capitaoananas/BRUV-mini/README.md

# Firefly Tinywhoop

A 75mm tinywhoop drone with a custom frame and canopy, made for indoors and outdoors

---

## Features

- **Small** – fly indoors and outdoors with the 75mm wheelbase
- **0802 motors** – Great speed and size!
- **AIO board** – (All In One) FC+ESC+OSD+VTX+RX
- **31mm props** – good efficiency and performance, aso can use 35mm props, no prop guards but who needs them?

---

## Bill of Materials (BOM)

| Part | Quantity | Price  | Link | Notes |
| --- | --- | --- | --- | --- |
| Matrix 1S FC (5in1) | 1 | $57.45 | [tinywhoop](https://www.tinywhoop.com/collections/electronics/products/matrixfc) |
| CADDXFPV Ant Lite Camera | 1 | $15.90 | [caddxfpv](https://caddxfpv.com/products/caddxfpv-ant-lite-4-3-fpvcycle-edition) |
| 802 25KKV Motors | 1 | $46.850 | [tinywhoop](https://www.tinywhoop.com/collections/802-motors/products/802-25kkv-calliope-edition-project-topspin-tiny-whoop-motors) |
| Gemfan 31mm props | 4 | $4.01 | [aliexpress](https://pt.aliexpress.com/item/1005009122072902.html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) |
| BT2.0 300mAh 1S battery | 1 pack of 4  | $19.99 | [betafpv](https://betafpv.com/collections/batt-1s/products/bt2-0-450mah-1s-30c-battery-4pcs) |
| m2x10 screws | 4 | $3.48 |  [aliexpress](https://pt.aliexpress.com/item/1005007249068859.html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) |
| nylon m2 nuts | 8 | $1.31 | [aliexpress](https://pt.aliexpress.com/item/1005005203028580.html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) |
| Carbon Fiber Sheet | 1 | $21.80 | [aliexpress](https://pt.aliexpress.com/item/1005008721256378.html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) |
| Radiomaster pocket controller | 1 | $76.36 | [aliexpress](https://pt.aliexpress.com/item/1005009135876837.html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) |

Total: `$247.15` + shipping
so needed ~$270+

---

## Drone overview

I made the frame and canopy in Fusion

### Frame

Side             |  Top
:-------------------------:|:-------------------------:
frame side  |  Frame top

---

### Canopy

Side             |  Top
:-------------------------:|:-------------------------:
canopy side  |  canopy top

Side (3D printed)             |  Side with frame (3D printed)
:-------------------------:|:-------------------------:
canopy side  |  canopy with frame side

---

### Final renders

i was not able to bend the canopy in Fusion so its not in the final renders

Side              |  Top             | Bottom
:-------------------------:|:-------------------------:|:-------------------------:
Render side  |  Render top | Render bottom

---
