capitaoananas/BRUV-mini/3D/antena mount.stl

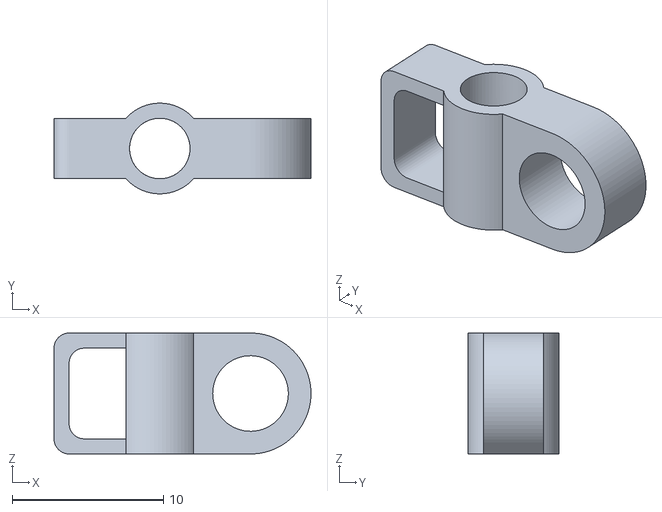
[picture p1: CAD file, 2025-06-12]
3D/antena mount.stl
17.0 x 5.99 x 8.00
