capitaoananas/BRUV-mini/3D/Frame top.step

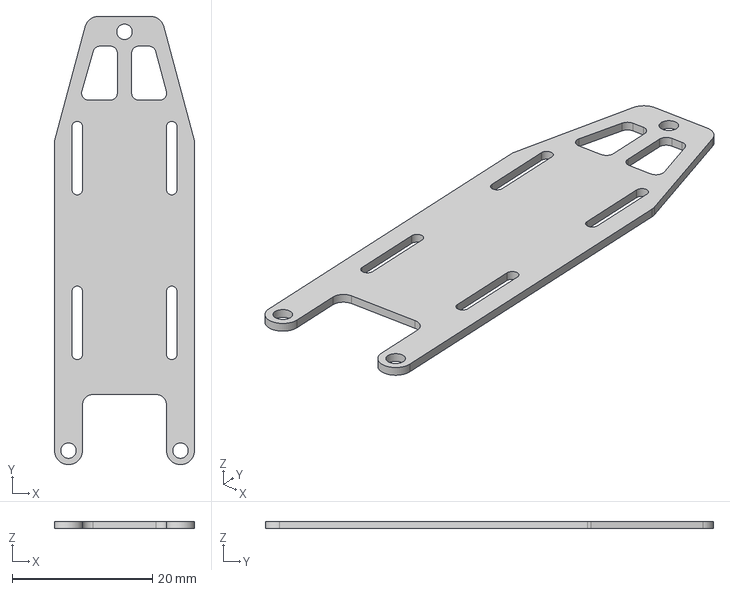
[picture p2: CAD file, 2025-06-12]
3D/Frame top.step
20.0 x 64.0 x 1.00 mm
