capitaoananas/BRUV-mini/3D/camera.stl

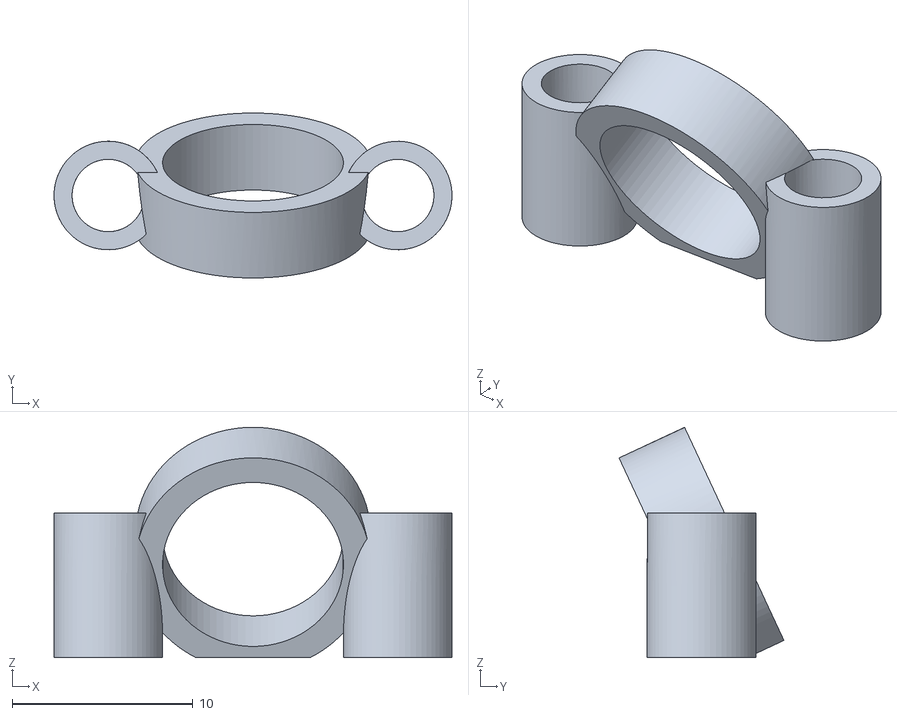
[picture p3: CAD file, 2025-06-12]
3D/camera.stl
22.0 x 9.12 x 12.7
