capitaoananas/BRUV-mini/3D/frame bottom.step

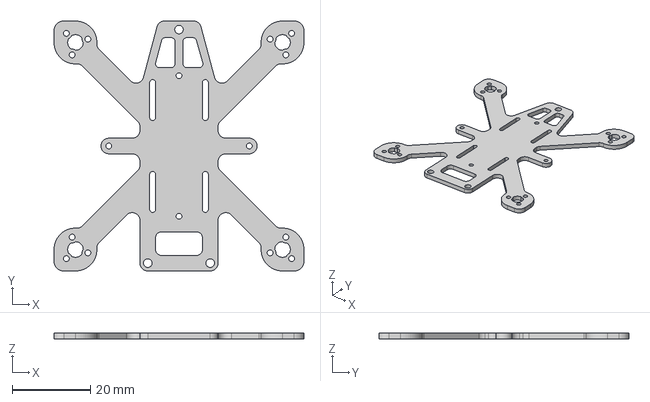
[picture p4: CAD file, 2025-06-12]
3D/frame bottom.step
64.0 x 64.0 x 1.50 mm
