capitaoananas/BRUV-mini/3D/BRUV_mini.step

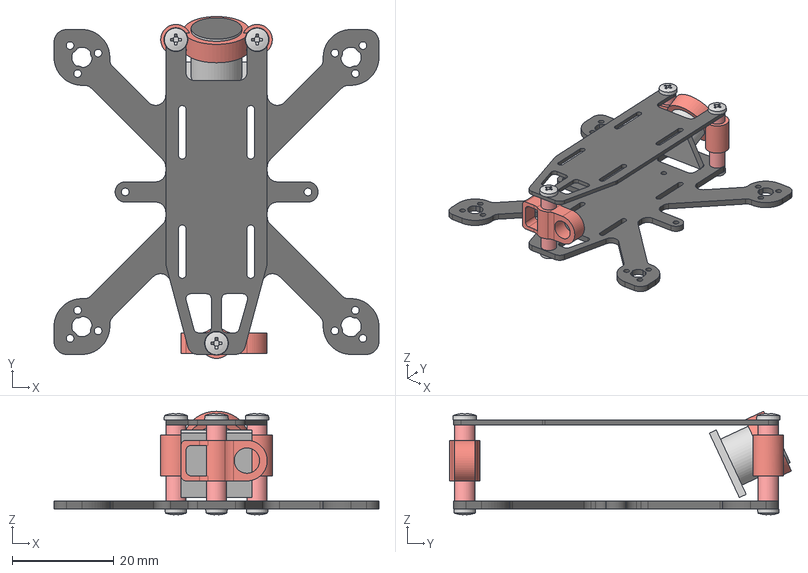
[picture p5: CAD file, 2025-06-12]
3D/BRUV_mini.step
64.0 x 67.4 x 20.4 mm
BHS JIS B 1111 - M2x4 Steel 4.6 Plain x 3
Frame top
BHS JIS B 1111 - M2.2x4 Steel 4.6 Plain x 3
