capitaoananas/BRUV-mini/(list of files, cad)

Other CAD files:
3D/Frame bottom.dxf
3D/Frame top.dxf
3D/frame bottom.stl
3D/frame top.stl
